Roland-Huisman/M847-extended-version-V1.1/PCB.jpg

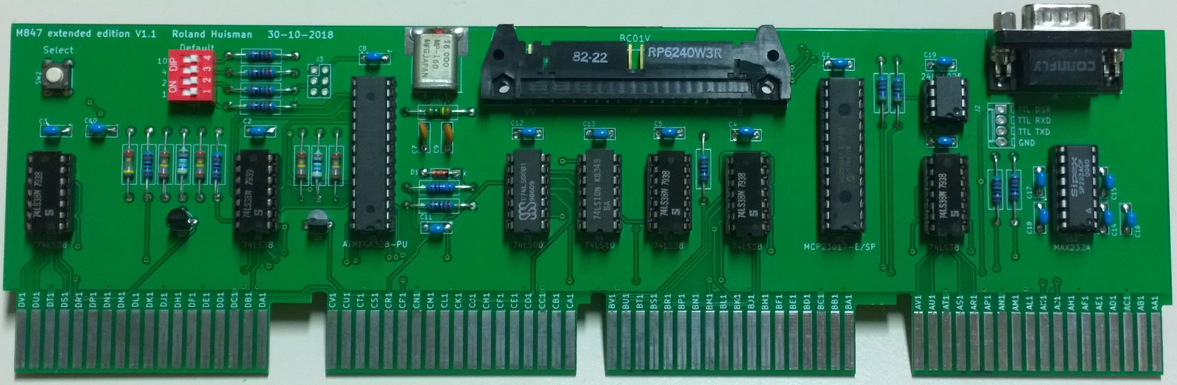
PCB.jpg
