Roland-Huisman/M847-extended-version-V1.1/Flash Arduino bootloader.jpg

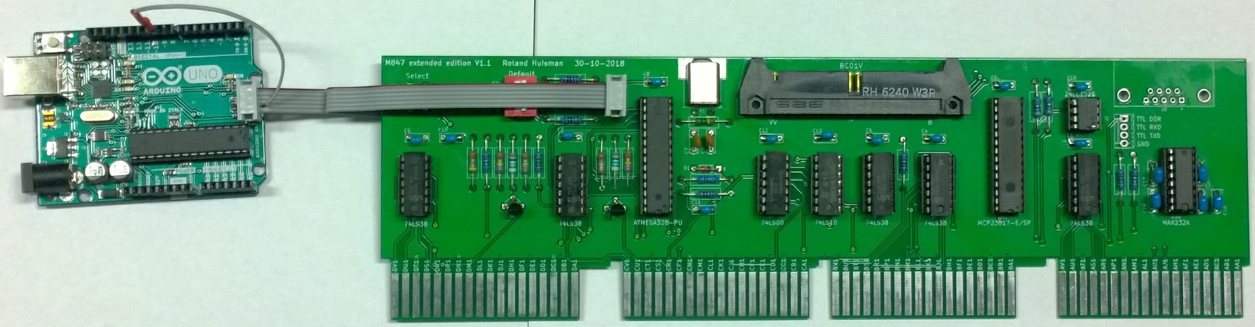
Flash Arduino bootloader.jpg
