Roland-Huisman/M847-extended-version-V1.1/Toggle in tests.pdf

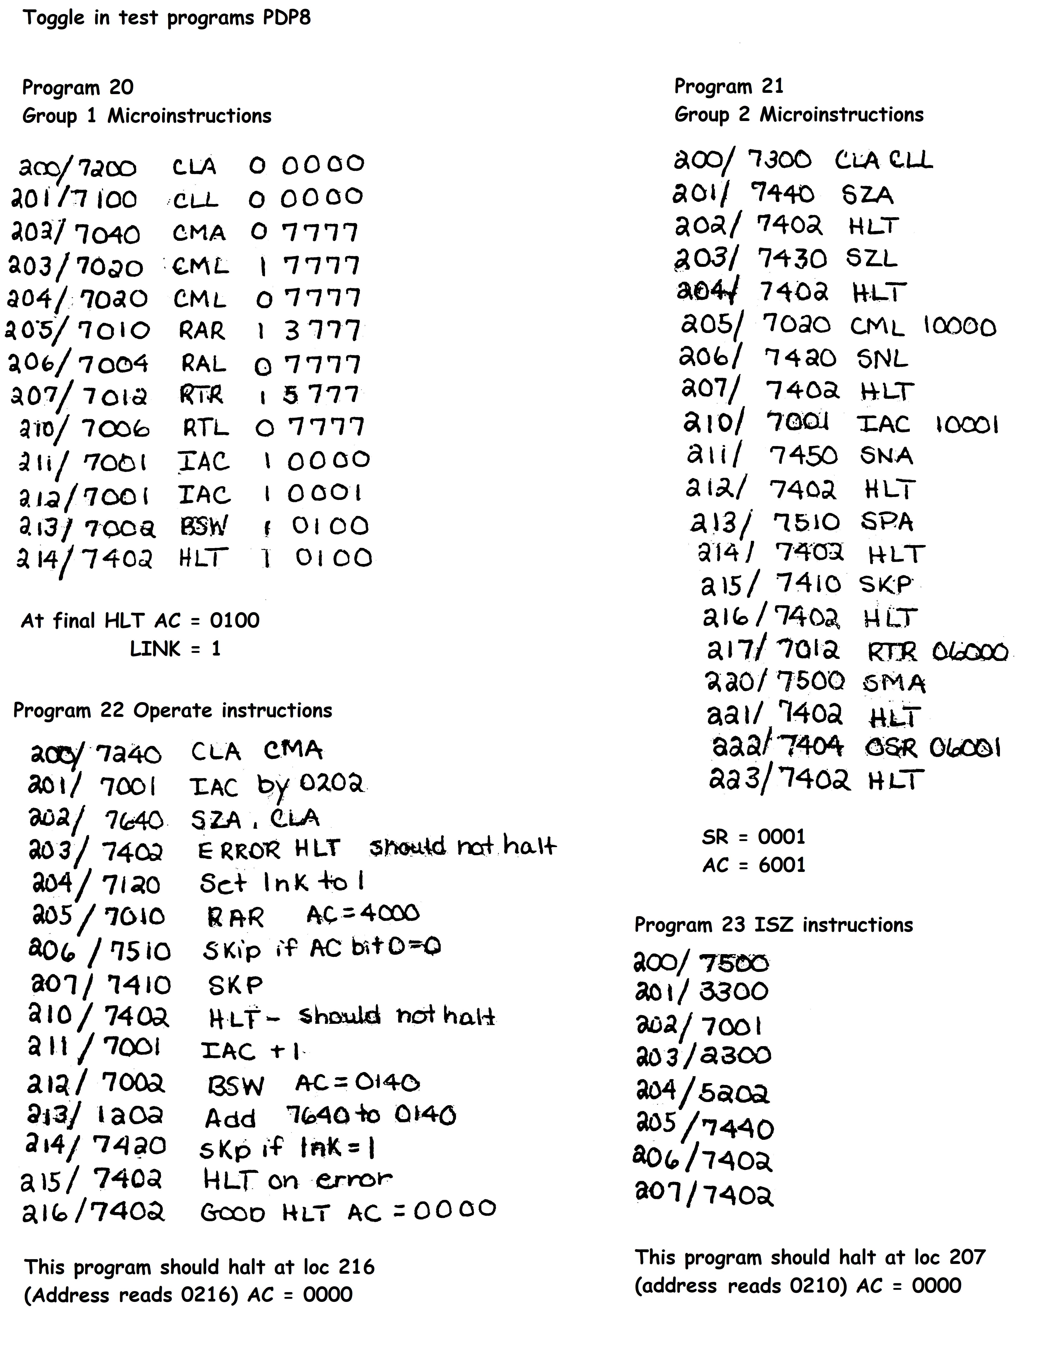
[picture p3: page 1]
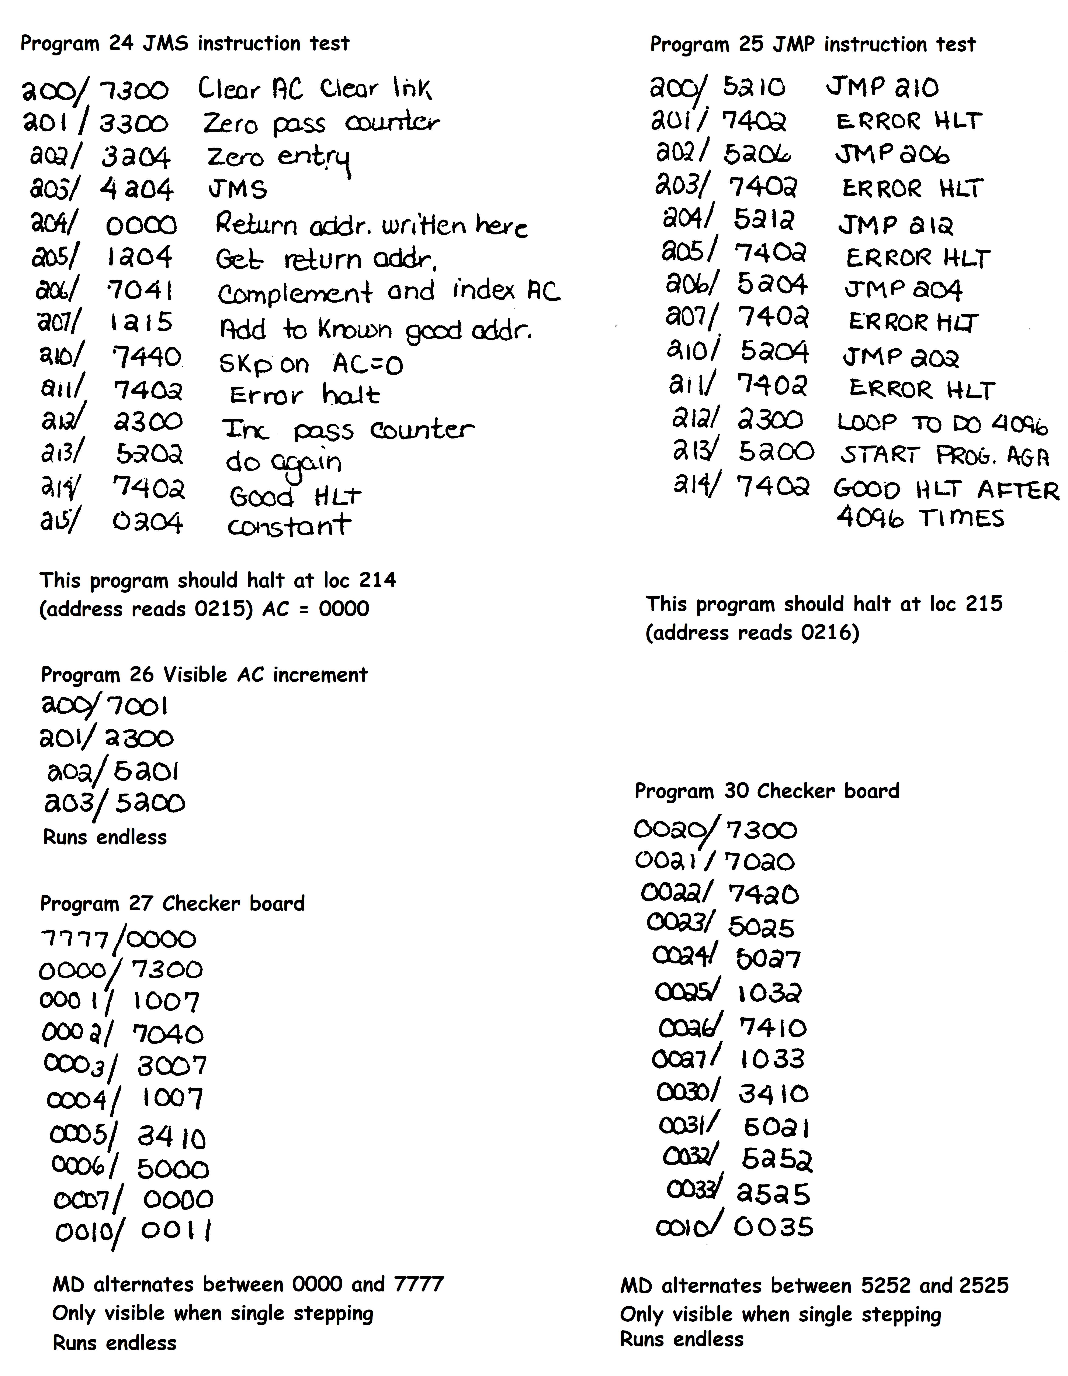
[picture p4: page 2]
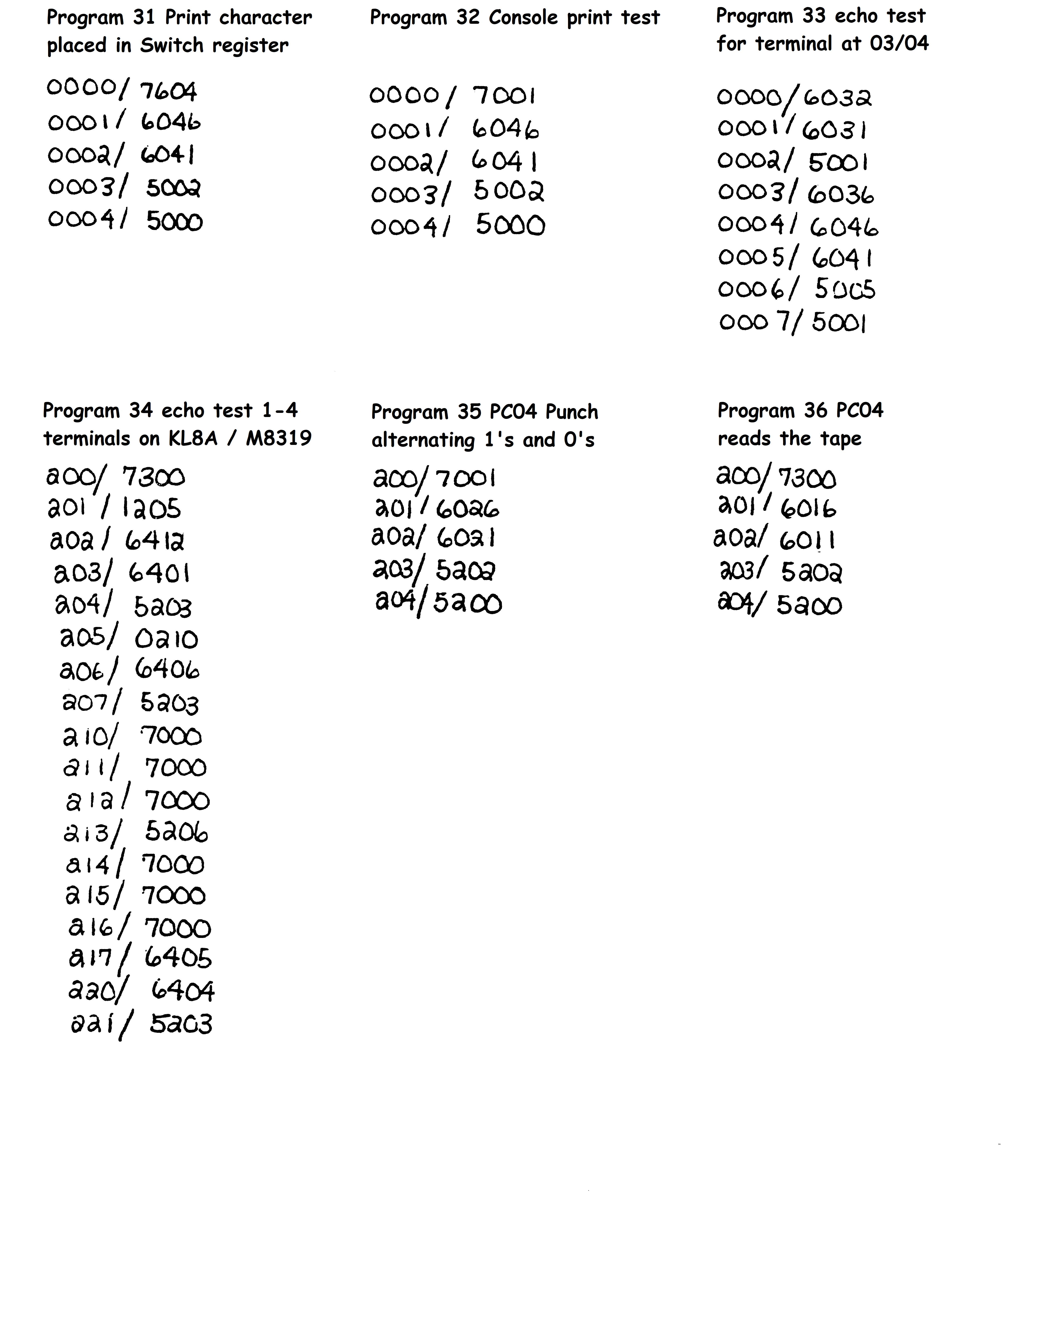
[picture p5: page 3]
