Roland-Huisman/M847-extended-version-V1.1/M847 extended version V1.1 schematic.pdf

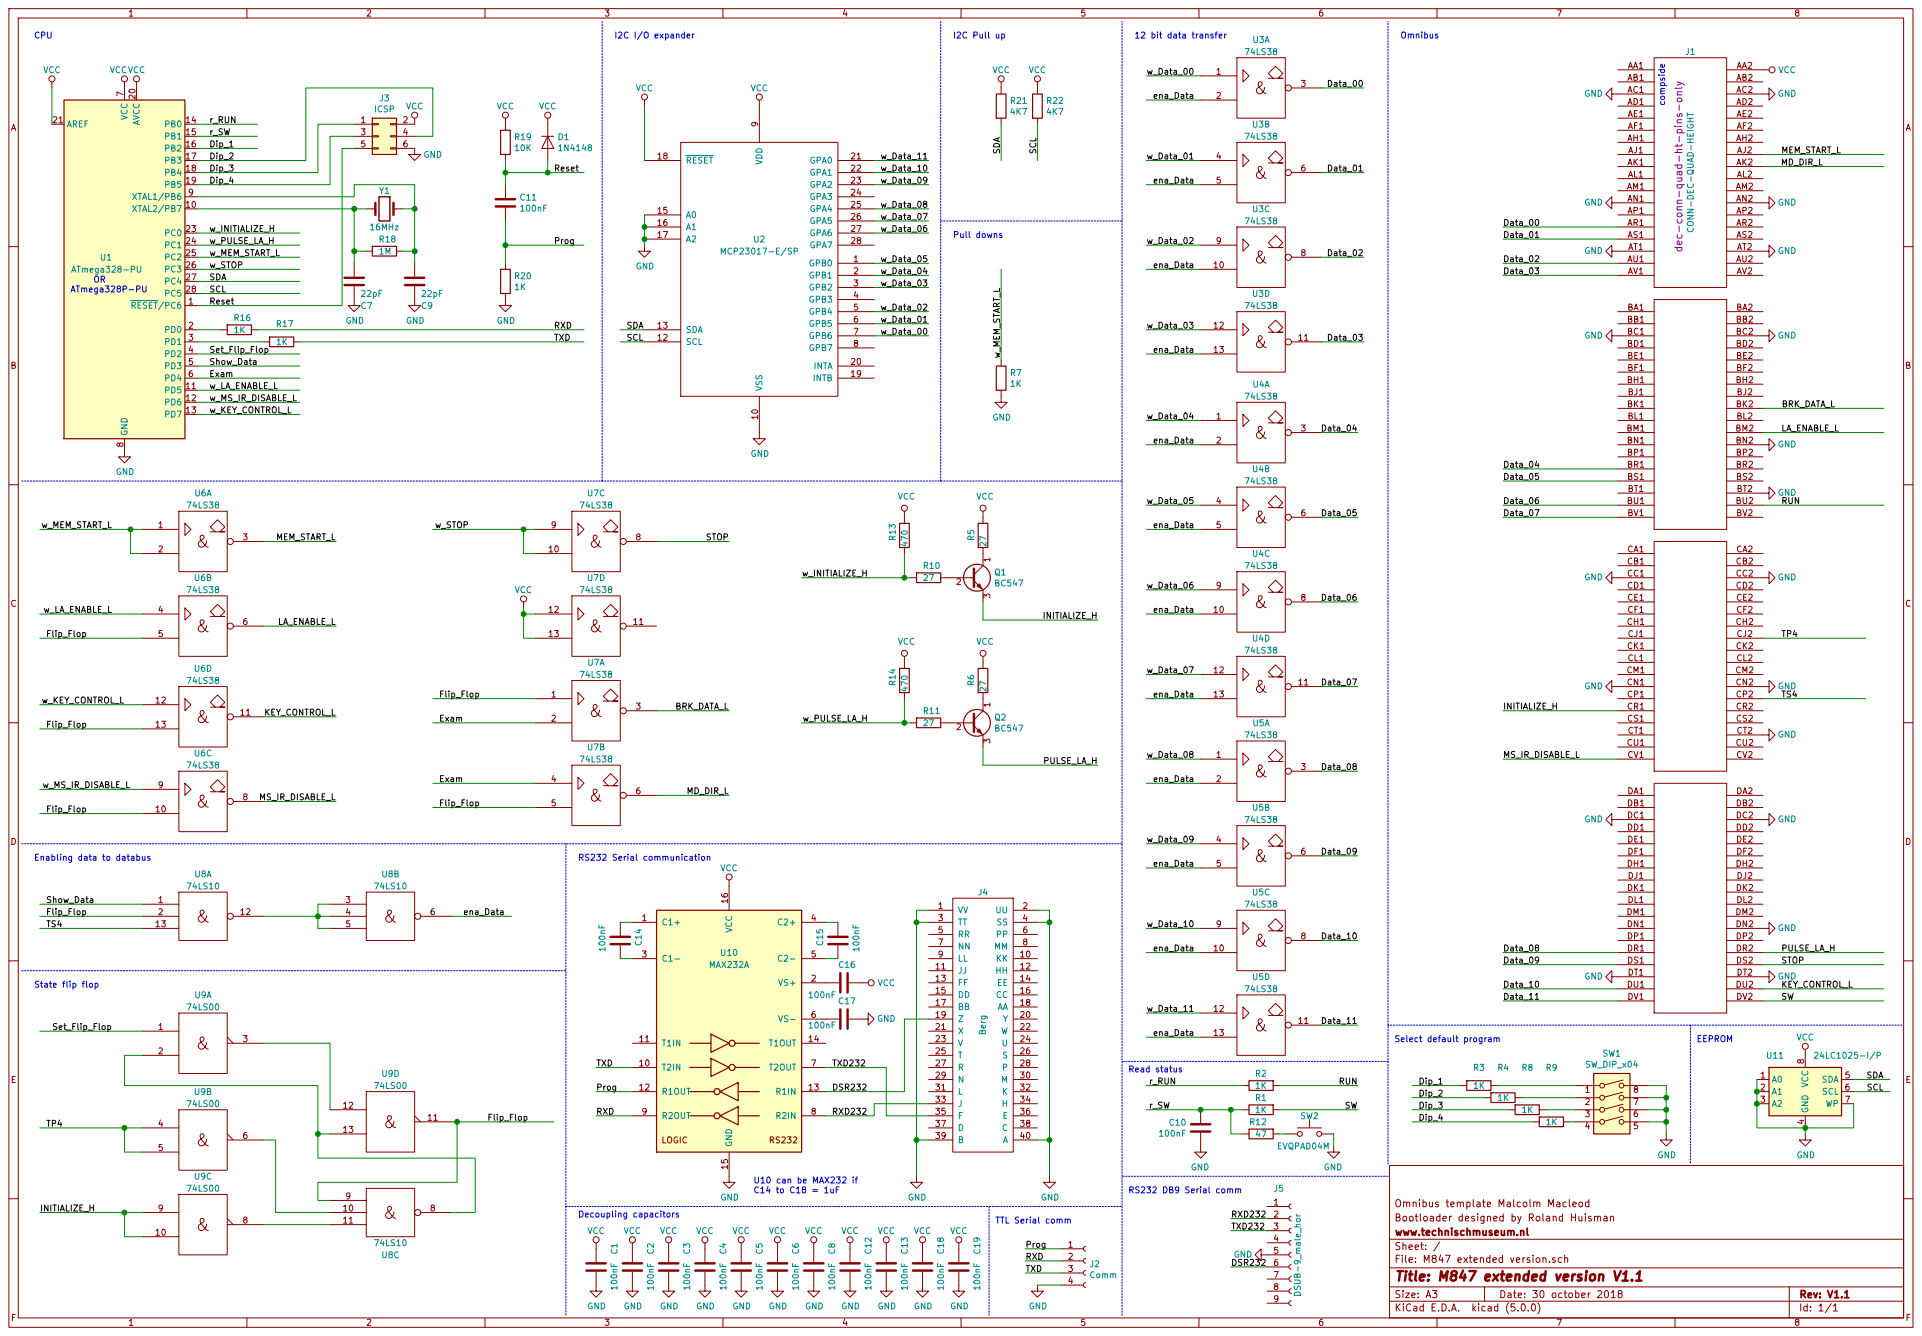
[picture p6: page 1]
