Roland-Huisman/M847-extended-version-V1.1/M847 extended version V1.1 component placement.pdf

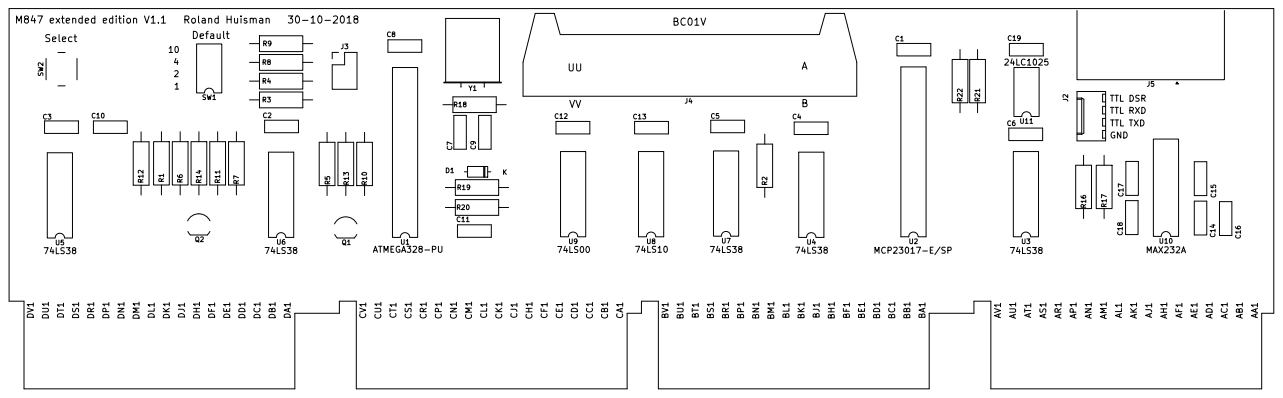
[picture p7: page 1]
