Roland-Huisman/M847-extended-version-V1.1/(commit log)

2018-12-22 Add files via upload
    Updated component list. The advice is to use the ATMEGA328P-PU if you choose to buy a blank chip.
    Still a pre loaded ATMEGA328P-PU with Arduino boot loader in it is preferred.
    [M847 extended version V1.2 component list Digikey.xls]
2020-04-12 Add files via upload
    Corrected an error in PC04 test program no 35.
    [M847_bootloader_firmware_V18.ino]
